excellent-lc/sesame-robot-micro/hardware/img/xiao-bat-pads-solder.jpg

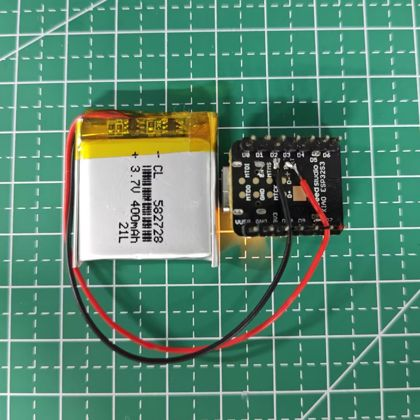
hardware/img/xiao-bat-pads-solder.jpg
