excellent-lc/sesame-robot-micro/hardware/img/xiao-esp32s3-pinout-front.jpg

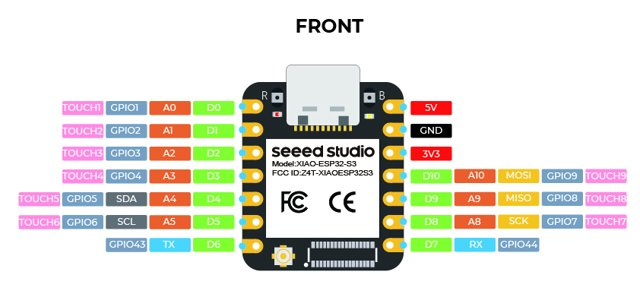
hardware/img/xiao-esp32s3-pinout-front.jpg
