excellent-lc/sesame-robot-micro/hardware/BOM.md

# Sesame Robot Micro — Bill of Materials (BOM)

> 本 BOM 参考原版 Sesame Robot 的电源/电子方案,针对 **Micro(2.1g 微型舵机四足)** 版本整理。
> 螺丝清单为 **CAD 逐孔交互实测**(2026-07-07 起重测,见 §4),测一条记一条,以实测为准。
> 暂不含购买链接。

---

## 1. 控制 / 电子 (Electronics)

| # | 组件 | 型号 / 规格 | 数量 | 说明 |
|---|---|---|---|---|
| E1 | 主控板 | **Seeed XIAO ESP32-S3** | 1 | 替代原"Metro Mini + WiFi 桥接"两块板,**单板集成主控 + WiFi/BLE**。3.3V 逻辑,11× GPIO,WiFi+BLE。 |
| E2 | OLED 显示屏 | **ER-OLEDM0.49**(0.49" **64×32**,SSD1306,I²C) | 1 | 显示表情;I²C 地址 `0x3C`,3.3V 供电。 |

> 排针/载板已移至 **第 6 节 耗材**(现有材料剪裁即可,无需采购)。

> ⚠️ **引脚预算**:8 舵机 + I²C OLED = 10/11 GPIO,WiFi 走片内不占脚。**离散脚已用满**(I²C 总线仍可挂更多传感器)。
> ⚠️ **PWM**:S3 的 LEDC 仅 8 路,8 舵机正好占满;固件用 `ESP32Servo`(非 `Servo.h`)。
> 🔌 视觉升级可选 **XIAO ESP32-S3 Sense**(同尺寸、同 MCU,带摄像头/麦克/SD);但 8 舵机 + 摄像头会撞 LEDC,建议视觉单独一颗芯片。

---

## 2. 执行机构 (Actuators)

| # | 组件 | 型号 / 规格 | 数量 | 说明 |
|---|---|---|---|---|
| A1 | 微型舵机 | **DM-S0020 2.1g Ultra-Micro Servo**(DOMAN RC) | **8** | **原厂工作电压 3.7–6.0V**;运行电流 ~35mA;180°,JR(2.54mm 3针)接口。自带舵盘;**horn 螺丝仅附 1 颗,不够装配用(见 §4 F1)**。 |

> Amazon 各卖家写的 "3.7–5V" / "4.8–6V" 只是原厂 **3.7–6.0V** 区间的不同截取,同一硬件。**3.7V 即在规格内 → 可 1S 直供**(满电 4.2V 接近推荐值;扭矩/速度按 @4.8V 标定,3.7–4.2V 下略低但够用)。

---

## 3. 电源系统 (Power)

> 方案:**1S 直供 / 无 DC-DC**(参考 [flix](https://github.com/okalachev/flix) 1S 直供有刷电机的成熟做法)。全机无器件强制要 5V(见 §1 与 §6 各器件电压:XIAO/OLED 走 3.3V,舵机 3.7–6.0V)。

| # | 组件 | 型号 / 规格 | 数量 | 说明 |
|---|---|---|---|---|
| P1 | 电池 | **1S LiPo 3.7V · 放电 ≥25C** ·主选 **102050**(~600–1000mAh)/留极耳余量选 **102040·802040**(~500–800mAh) | 1 | **直供全场**。合机身底部电池仓 ≈ **20×10×50mm**(CAD 建模电池块同此尺寸)。满电 4.2V / 空 3.0V,落在舵机 3.7–6.0V 内。⚠️ 极耳+导线超本体 5–15mm,仓仅 50mm → 纯 102050 偏顶,**优先本体 40mm 款**。**放电倍率 ≥25C**(预留复用无人机,见表下注)。⚠️ 高倍率电芯多**不带 PCM**(带 PCM 也会限流、废掉 25C)→ **低压保护以固件 ADC 切断为主(防过放)**。出厂多为 JST-PH 2.0;XIAO 是 BAT 焊盘,直焊或加转接线。 |
| P2 | 电源开关 | **SPDT Mini Slide Switch** | 1 | 串在电池正极与负载之间(CAD 已建模该开关位)。 |
<!-- | P3 | 滤波电容 | 电解电容 470–1000µF / ≥10V | 1 | 接电池 V+ 轨,吸收舵机/WiFi 电流尖峰,稳压。 | (暂不装,遇 WiFi burst/舵机启动瞬间欠压再加回) -->
| P4 | 升压稳压(**可选**) | 1S→5V 升压:**MT3608**(调压 ~36×17mm)/ **TPS61023**(小 ~18×16mm)/ **PowerBoost 500C**(升压+1S充电二合一 ~36×22mm) | 0–1 | **默认不用**(参考 flix 的"可选稳压")。仅当 WiFi 发射偶发欠压/复位才加,调到 5.0V 给舵机轨。⚠️ 升压抬高电池电流(5V2A≈从电池取 3A/~4C),**先试加回 P3 电容**(上方已注释)再考虑升压。 |

> 🚁 **P1 为什么要 ≥25C**:预留后续**同一块电池复用做 1S 无人机**(参考 flix 的 1S 有刷四轴,4× 8520 空心杯峰值合计可 >10A)。600–1000mAh @25C = **15–25A 持续放电**,无人机够用;四足本身(8 舵机合计 <1A,≈1–2C)对倍率不敏感,采购规格按无人机需求取高即可通用。

**供电拓扑(1S 直供):**
```
1S LiPo(3.0–4.2V)
   └ 开关(P2) ─┬─→ XIAO ESP32-S3  BAT 焊盘   (直供 + USB-C 板载充电)
               │        └─ XIAO 3V3 脚 → OLED VCC
               └─→ 8× 舵机 V+(3.7–4.2V 直供)
   全部共地(舵机棕线 / XIAO GND / OLED GND)
   无 Buck / 无 Boost / 无外置充电板;升压 P4 仅作可选稳压
```

> 🔌 **接线图**: `hardware/wiring.svg`(含舵机通道→GPIO 映射与固件移植片段;改动后用 `python3 tools/make_wiring_svg.py` 重新生成)。

---

## 4. 紧固件 (Fasteners) — 交互实测清单(以此为准)

> 旧版"按孔径反推估算"的螺丝清单已**作废删除**。以下为 **Fusion 逐孔交互实测**结果(选中孔面 → API 读几何),测一条记一条(2026-07-07 起)。

| # | 组件 | 规格 | 数量 | 用途 / 实测依据 |
|---|---|---|---|---|
| **F1** | 舵盘固定自攻螺丝 | **M1.4×3 自攻(盘头)** | **8** | **髋/腿 ↔ 舵盘(arm_double)**,每髋 1 颗 + 每腿 1 颗(共 4+4)。实测 2 处同规格:舵盘孔 **Ø0.8** 通孔(臂厚 1.2mm);打印件侧孔 **Ø1.0**(壁厚 0.6–0.8mm,一处带 45° 倒角口 Ø2.0);咬合 ≈2mm → 长 2.5–3mm 合适。**舵机只附带 1 颗,不够 → 需采购。** |
| **F2** | 舵机耳片固定自攻螺丝 | **M1.4×4 自攻(盘头)** | **16** | **舵机耳片 ↔ 腿/骨架打印件**,每舵机 2 颗 × 8。实测(F-L4):耳片过孔 **Ø1.72**(耳厚 1.0mm);打印件底孔 **Ø1.06 × 深3.6mm**,紧贴耳片背面 → ×4 咬合 ≈3mm(×3 亦可用,咬合略短)。与 F1 同为 M1.4 自攻,可买混长度套装。 |
| **F3** | 舵机壳固定自攻螺丝 | **M2×4 自攻(盘头)** | **8** | **髋支架 ↔ 舵机壳体自带螺孔**,每舵机 1 颗。实测(hip_lr↔servo:8):髋过孔 **Ø2.1**(壁 0.76mm);舵机壳孔 **Ø1.5 × 深2.85mm**(M2 自攻标准底孔),中间间隙 ≈0.7mm → ×4 咬合 ≈2.5mm(**×5 会顶底,勿用**)。 |
| **F4** | 电源开关固定自攻螺丝 | **M2×4 自攻(盘头)** | **2** | **SPDT 开关支架 ↔ 上盖后斜面**。实测:上盖底孔 **Ø1.48 × 深2.65mm**(通孔凸台,螺尖可冒头进空腔),孔距 15mm(SS-12D00 标准);螺丝穿开关支架过孔拧入。**与 F3 同规格,合并采购 M2×4 共 10 颗。** |
| **F5** | 下盖固定自攻螺丝 | **M2×8 自攻(盘头)** | **4** | **下盖 ↔ 内部骨架凸台**,从底部竖直拧入,四角分布(CAD 数孔确认)。实测:下盖 **Ø1.75 × 3mm**(底面 45° 倒角口 Ø2.26)+ 骨架凸台 **Ø1.75 × 6.5mm**,同轴无缝,总深 9.5mm → ×8 咬合 8mm,留 1.5mm 余量(**×10 有顶底风险,勿用**)。 |
| **F6** | 上盖固定自攻螺丝 | **M2×8 自攻(盘头)** | **4** | **内部骨架 ↔ 上盖长凸台**,从骨架下方竖直拧入,机身中部矩形分布(CAD 数孔确认 4 处)。实测:骨架过孔 **Ø2.1 × 4.9mm** + 上盖凸台底孔 **Ø1.5 × 深12.7mm** → ×8 咬合 3.1mm,凸台余量大无顶底风险。**与 F5 同规格,合并采购 M2×8 共 8 颗。** |

> 🔄 其余孔位测量进行中,逐条补充。

---

## 5. 3D 打印件 (Printed Parts) — 不在采购范围,自行打印

| # | 文件 | 数量 | 说明 |
|---|---|---|---|
| M1 | `STL/hip-1.stl` ~ `hip-4.stl` | 4 | 髋部 |
| M2 | `STL/leg-1.stl` ~ `leg-4.stl` | 4 | 腿 |
| M3 | `STL/internal-frame.stl` | 1 | 内部骨架(承载电子/电源) |
| M4 | `STL/top-cover.stl` | 1 | 上盖 |
| M5 | `STL/Bottom-Cover.stl` | 1 | 下盖 |

> CAD 源文件:`CAD/Sesame-Micro.f3z`(Fusion)/ `CAD/Sesame-Micro.step`。

---

## 6. 线材 / 耗材 (Wiring & Consumables)

| # | 组件 | 规格 | 说明 |
|---|---|---|---|
| W1 | 排针 | **2.54mm 直插公排针**(用现有,**无需采购**) | 舵机/模块接线;舵机 JR 接口 = 2.54mm 3针,对应。用量 8×3=24 针(掰一条单排针)。 |
| W2 | 载板 | **2.54mm 通用洞洞板**(现有剪裁,**无需采购**) | 5V 配电 + 舵机排针汇流;原方案 5×7cm 太大,沿孔位剪到 ~43×15mm 塞进电路位即可;用 XIAO S3 也可飞线省掉。 |
| W3 | 导线 | 杜邦线 / 细硅胶线(28–26AWG) | 舵机延长、5V 配电、信号线 |
| W4 | 焊接耗材 | 焊锡、热缩管 | 接线 |

---

## 7. 工具 (Tools)

| # | 工具 | 用途 |
|---|---|---|
| T1 | 电烙铁 | 焊接接线 |
| T2 | 小号螺丝刀 | 装配螺丝(规格见 §4 实测清单) |
| T3 | 万用表 | 调 Buck 输出电压、查接线 |
| T4 | USB-C 数据线 | XIAO BAT 焊盘接 1S 后,插 USB-C 即板载给电池充电 |

---

## 待确认项 (To verify before purchase)

1. ~~DM-S0020 实际额定电压~~ → ✅ 已确认:DOMAN 原厂 **3.7–6.0V**,1S 直供可行(满电 4.2V 近推荐值)。
2. ~~电池实际可放尺寸~~ → ✅ 已确认:机身底部有专用电池仓 ≈ **20×10×50mm**;电池仓偏窄,**改用 1S LiPo 直供**(见 §3),无需 2S。
3. 各螺丝规格/数量 → 🔄 **逐孔交互实测中**(见 §4),旧估算(M2×5/M3×10 等)已作废。
