excellent-lc/sesame-robot-micro/hardware/CAD/Sesame-Micro.FCStd

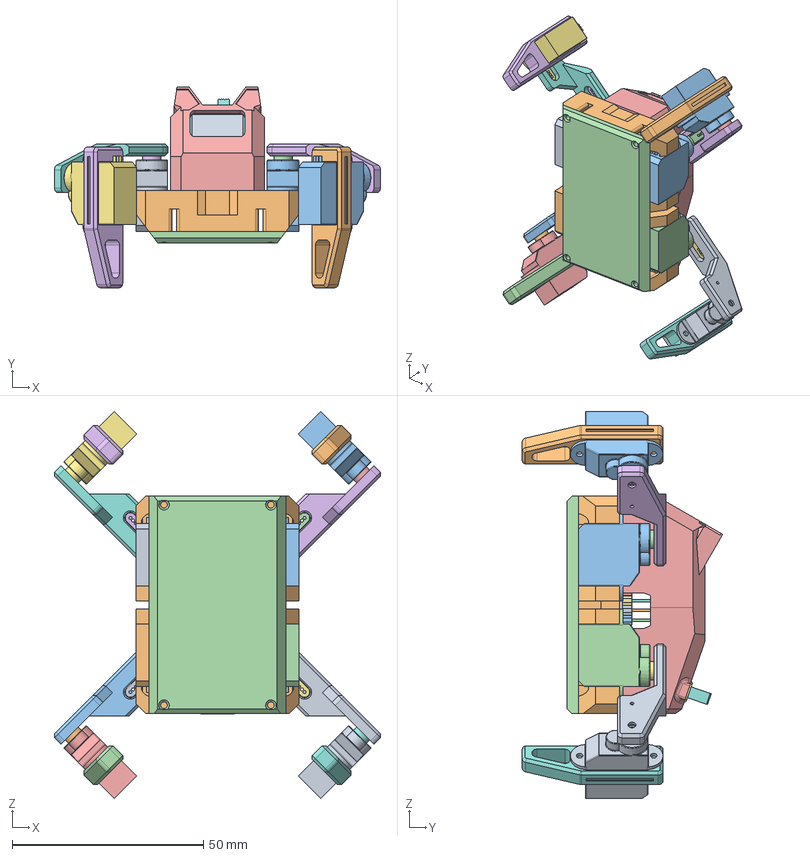
[picture p3: CAD file, 2026-07-08]
hardware/CAD/Sesame-Micro.FCStd
85.2 x 52.4 x 101.2 mm
S1_body
S2_body
S3_body
S4_body
switch plate 2
switch pin 2
switch body 2
switch head 2
switch pin 001
switch pin 002
BOSS-EXTRUDE14_8_
BOSS-EXTRUDE7_4_
BOSS-EXTRUDE7_3_
BOSS-EXTRUDE14_4_
BOSS-EXTRUDE14_2_
BOSS-EXTRUDE14_11_
BOSS-EXTRUDE7_7_
BOSS-EXTRUDE14_9_
BOSS-EXTRUDE14_3_
BOSS-EXTRUDE14_7_
MIRROR2
BOSS-EXTRUDE14_5_
BOSS-EXTRUDE14_12_
BOSS-EXTRUDE7_8_
BOSS-EXTRUDE7_1_
BOSS-EXTRUDE14_10_
BOSS-EXTRUDE7_9_
BOSS-EXTRUDE14_6_
BOSS-EXTRUDE14_1_
BOSS-EXTRUDE7_6_
BOSS-EXTRUDE7_2_
CUT-EXTRUDE5
BOSS-EXTRUDE7_5_
U.FL Connector v1
U.FL Connector v001
U.FL Connector v002
Button (1)
Shield
Button (1)001
pinout
pinout001
pinout002
pinout003
pinout004
pinout005
pinout006
pinout007
pinout008
pinout009
pinout010
pinout011
waveshare
waveshare001
waveshare002
waveshare003
waveshare004
waveshare005
waveshare006
waveshare007
waveshare008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
