excellent-lc/sesame-robot-micro/(commit log)

2026-06-27 feat:bom 文件
2026-06-27 feat: 修改bom
2026-07-07 feat:螺丝
2026-07-08 chore: uv 工程化 + .gitignore
    依赖仅仿真用(pybullet/pillow);忽略 venv、FreeCAD 备份、可再生 STEP 中间件
2026-07-08 docs: CLAUDE.md CAD 操控索引
2026-07-08 feat: Fusion/FreeCAD 自动化工具链
    fusion_tool 子命令工具箱 + fusion_rpc/fc_rpc 双桥 + Fusion→FreeCAD 转换流水线
2026-07-08 feat: Fusion 导出数据与关节测试
    structure/physical/links JSON(STEP 中间件不入库) + fusion_joint_test
2026-07-08 feat: FreeCAD 装配 Sesame-Micro.FCStd
    9链+8关节带颜色装配,转换流水线产物,扰动测试 PASS
    [Sesame-Micro.FCStd]
2026-07-08 feat:重新结构化
2026-07-10 feat: 接线图
